DucMinhLe2005/Human-Aware---Social-Navigation/docs/images/human_aware_navigation_pipeline.png

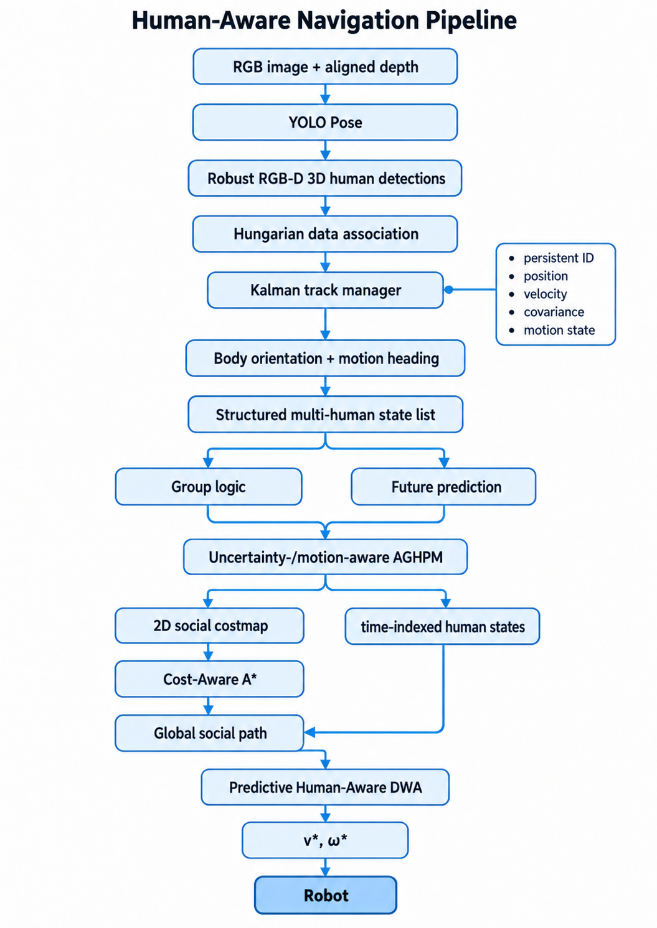
docs/images/human_aware_navigation_pipeline.png
