DucMinhLe2005/Human-Aware---Social-Navigation/docs/images/robot_cad.webp

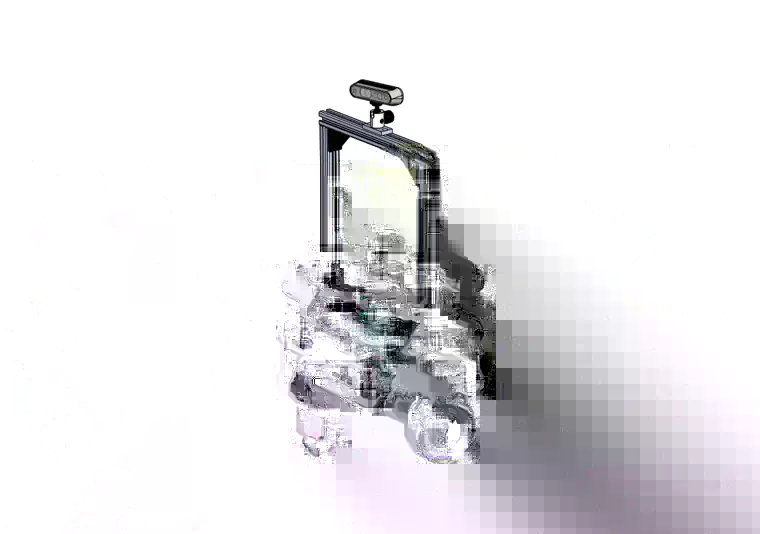
docs/images/robot_cad.webp
