DucMinhLe2005/Human-Aware---Social-Navigation/src_humanaware/src/linorobot2/linorobot2_description/meshes/my_amr/wheel_right.STL

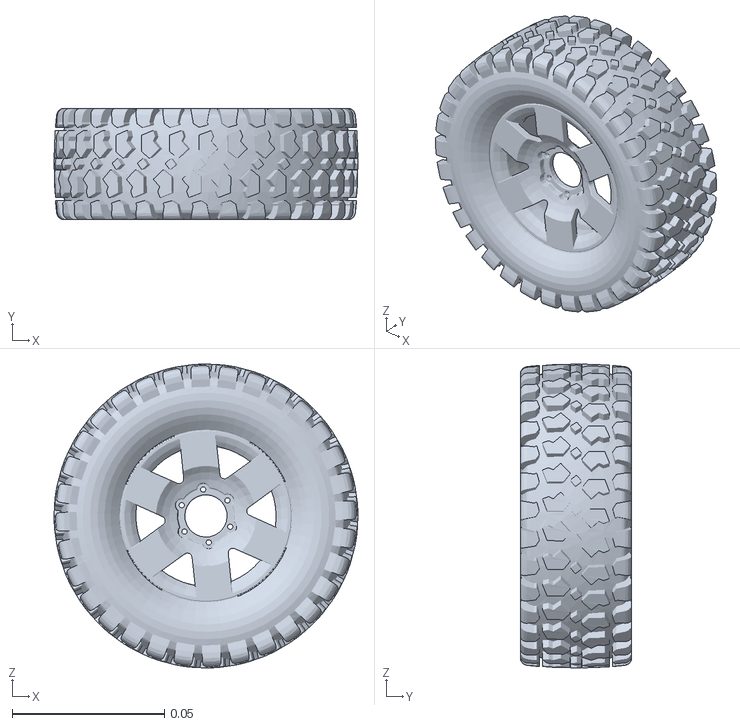
[picture p29: CAD file, 2026-10-07]
src_humanaware/src/linorobot2/linorobot2_description/meshes/my_amr/wheel_right.STL
0.1 x 0.0366 x 0.1
