DucMinhLe2005/Human-Aware---Social-Navigation/src_humanaware/src/linorobot2/linorobot2_gazebo/models/nurse/meshes/Nurse.obj

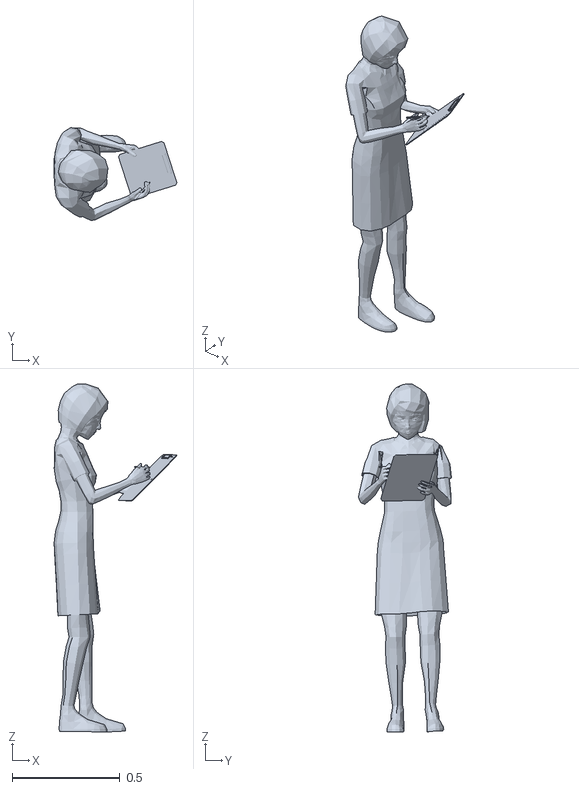
[picture p30: CAD file, 2026-10-07]
src_humanaware/src/linorobot2/linorobot2_gazebo/models/nurse/meshes/Nurse.obj
0.57 x 0.432 x 1.62
