DucMinhLe2005/Human-Aware---Social-Navigation/src_humanaware/src/linorobot2/linorobot2_gazebo/models/nurse/meshes/Nurse_Col.obj

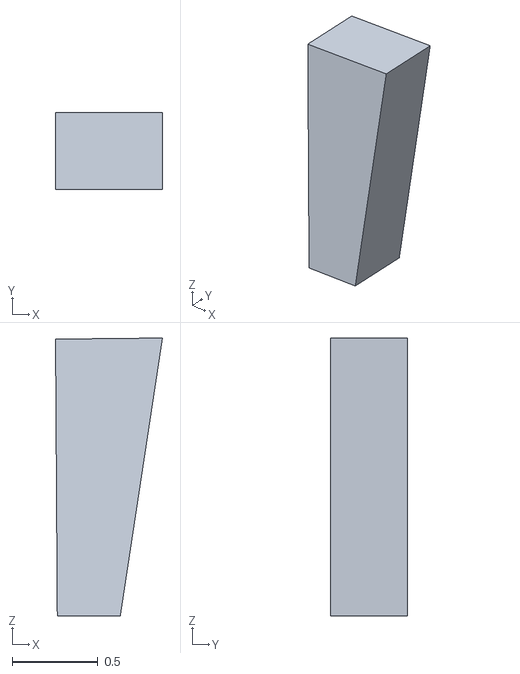
[picture p31: CAD file, 2026-10-07]
src_humanaware/src/linorobot2/linorobot2_gazebo/models/nurse/meshes/Nurse_Col.obj
0.622 x 0.446 x 1.62
