DucMinhLe2005/Human-Aware---Social-Navigation/src_humanaware/src/linorobot2/linorobot2_description/meshes/my_amr/caster_front.STL

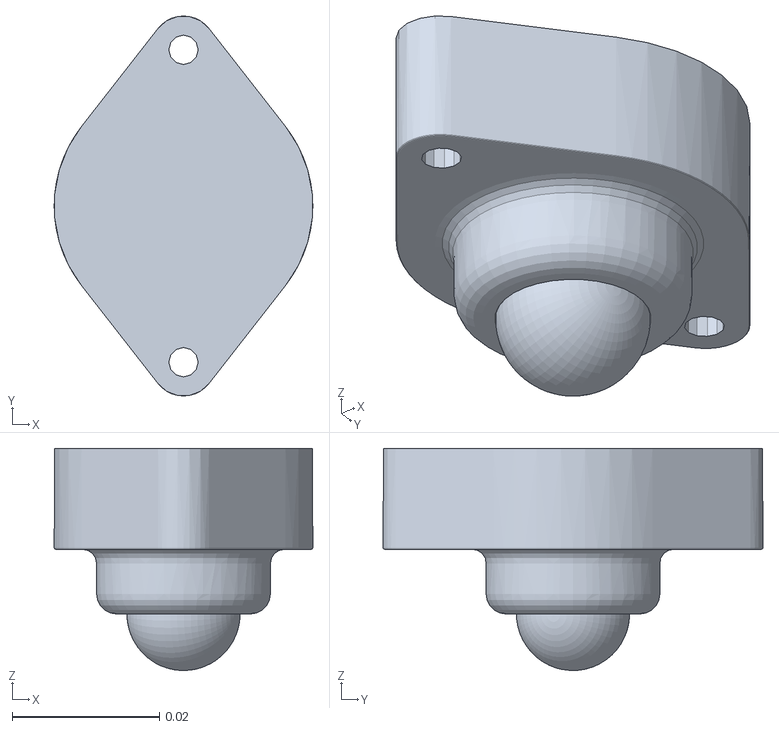
[picture p32: CAD file, 2026-10-07]
src_humanaware/src/linorobot2/linorobot2_description/meshes/my_amr/caster_front.STL
0.0352 x 0.0517 x 0.0302
