DucMinhLe2005/Human-Aware---Social-Navigation/src_humanaware/src/linorobot2/linorobot2_description/meshes/my_amr/imu_link.STL

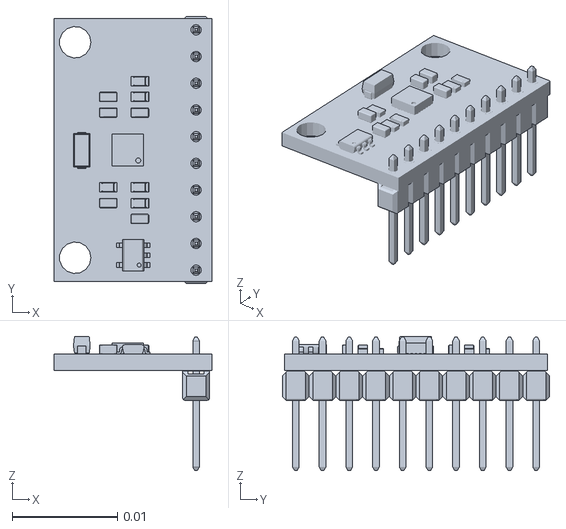
[picture p33: CAD file, 2026-10-07]
src_humanaware/src/linorobot2/linorobot2_description/meshes/my_amr/imu_link.STL
0.015 x 0.0254 x 0.0128
