DucMinhLe2005/Human-Aware---Social-Navigation/src_humanaware/src/linorobot2/linorobot2_description/meshes/my_amr/lidar_link.STL

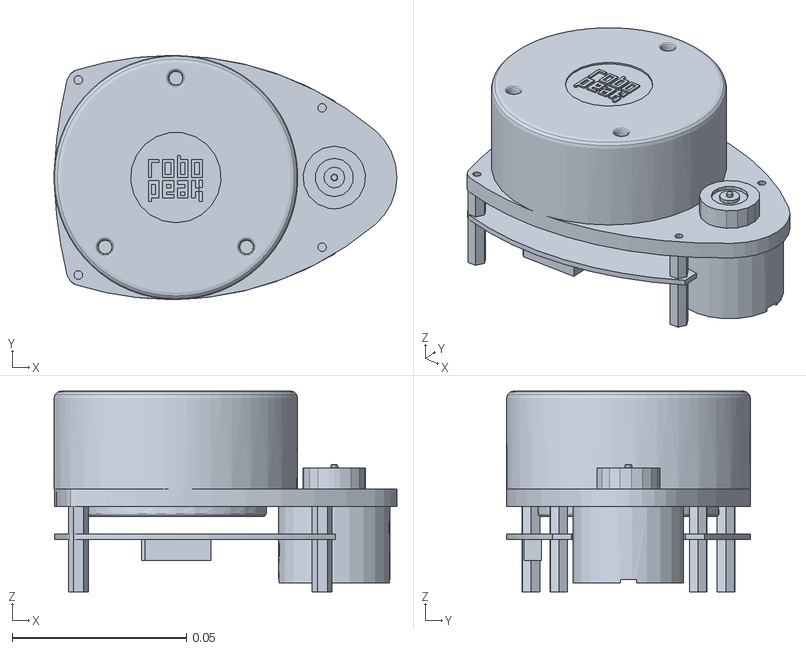
[picture p34: CAD file, 2026-10-07]
src_humanaware/src/linorobot2/linorobot2_description/meshes/my_amr/lidar_link.STL
0.0985 x 0.07 x 0.0577
