DucMinhLe2005/Human-Aware---Social-Navigation/src_humanaware/src/linorobot2/linorobot2_description/meshes/my_amr/camera_link.STL

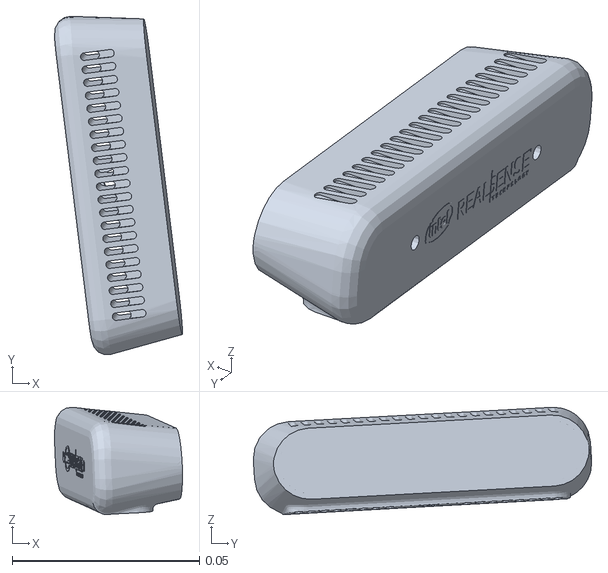
[picture p35: CAD file, 2026-10-07]
src_humanaware/src/linorobot2/linorobot2_description/meshes/my_amr/camera_link.STL
0.0342 x 0.0903 x 0.0287
