DucMinhLe2005/Human-Aware---Social-Navigation/(list of files, cad)

Other CAD files:
src_humanaware/src/linorobot2/linorobot2_description/meshes/my_amr/wheel_left.STL
src_humanaware/src/linorobot2/linorobot2_description/meshes/my_amr/caster_rear.STL
