DucMinhLe2005/Human-Aware---Social-Navigation/linorobot2_hardware/firmware/src/firmware.ino

// Copyright (c) 2021 Juan Miguel Jimeno
//
// Licensed under the Apache License, Version 2.0 (the "License");
// you may not use this file except in compliance with the License.
// You may obtain a copy of the License at
//
//     http://www.apache.org/licenses/LICENSE-2.0
//
// Unless required by applicable law or agreed to in writing, software
// distributed under the License is distributed on an "AS IS" BASIS,
// WITHOUT WARRANTIES OR CONDITIONS OF ANY KIND, either express or implied.
// See the License for the specific language governing permissions and
// limitations under the License.
#include <Arduino.h>
#include <micro_ros_platformio.h>
#include <stdio.h>

#include <rcl/rcl.h>
#include <rcl/error_handling.h>
#include <rclc/rclc.h>
#include <rclc/executor.h>

#include <nav_msgs/msg/odometry.h>
#include <sensor_msgs/msg/imu.h>
#include <sensor_msgs/msg/magnetic_field.h>
#include <geometry_msgs/msg/twist.h>
#include <geometry_msgs/msg/vector3.h>

#include "config.h"
#include "syslog.h"
#include "motor.h"
#include "kinematics.h"
#include "pid.h"
#include "odometry.h"
#include "imu.h"
#include "mag.h"
#define ENCODER_USE_INTERRUPTS
#define ENCODER_OPTIMIZE_INTERRUPTS
#include "encoder.h"
#include "lidar.h"
#include "wifis.h"
#include "ota.h"

#ifdef MICRO_ROS_TRANSPORT_ARDUINO_WIFI
// remove wifi initialization code from wifi transport
static inline void set_microros_net_transports(IPAddress agent_ip, uint16_t agent_port)
{
    static struct micro_ros_agent_locator locator;
    locator.address = agent_ip;
    locator.port = agent_port;

    rmw_uros_set_custom_transport(
        false,
        (void *) &locator,
        platformio_transport_open,
        platformio_transport_close,
        platformio_transport_write,
        platformio_transport_read
    );
}
#endif

#ifndef NODE_NAME
#define NODE_NAME "linorobot_base_node"
#endif

#ifndef RCCHECK
#define RCCHECK(fn) { rcl_ret_t temp_rc = fn; if((temp_rc != RCL_RET_OK)){rclErrorLoop();}}
#endif
#define RCSOFTCHECK(fn) { rcl_ret_t temp_rc = fn; if((temp_rc != RCL_RET_OK)){}}
#define EXECUTE_EVERY_N_MS(MS, X)  do { \
  static volatile int64_t init = -1; \
  if (init == -1) { init = uxr_millis();} \
  if (uxr_millis() - init > MS) { X; init = uxr_millis();} \
} while (0)

rcl_publisher_t odom_publisher;
rcl_publisher_t imu_publisher;
rcl_publisher_t mag_publisher;
rcl_publisher_t pid_setpoint_publisher;
rcl_publisher_t pid_measured_publisher;
rcl_publisher_t pid_output_publisher;

rcl_subscription_t twist_subscriber;
rcl_subscription_t pid_gains_subscriber;

nav_msgs__msg__Odometry odom_msg;
sensor_msgs__msg__Imu imu_msg;
sensor_msgs__msg__MagneticField mag_msg;
geometry_msgs__msg__Twist twist_msg;
geometry_msgs__msg__Vector3 pid_gains_msg;
geometry_msgs__msg__Vector3 pid_setpoint_msg;
geometry_msgs__msg__Vector3 pid_measured_msg;
geometry_msgs__msg__Vector3 pid_output_msg;

rclc_executor_t executor;
rclc_support_t support;
rcl_allocator_t allocator;
rcl_node_t node;
rcl_timer_t control_timer;

unsigned long long time_offset = 0;
unsigned long prev_cmd_time = 0;
unsigned long prev_odom_update = 0;

enum states
{
    WAITING_AGENT,
    AGENT_AVAILABLE,
    AGENT_CONNECTED,
    AGENT_DISCONNECTED
};

states state = WAITING_AGENT;

bool cmd_vel_received = false;

Encoder motor1_encoder(MOTOR1_ENCODER_A, MOTOR1_ENCODER_B, COUNTS_PER_REV1, MOTOR1_ENCODER_INV);
Encoder motor2_encoder(MOTOR2_ENCODER_A, MOTOR2_ENCODER_B, COUNTS_PER_REV2, MOTOR2_ENCODER_INV);
Encoder motor3_encoder(MOTOR3_ENCODER_A, MOTOR3_ENCODER_B, COUNTS_PER_REV3, MOTOR3_ENCODER_INV);
Encoder motor4_encoder(MOTOR4_ENCODER_A, MOTOR4_ENCODER_B, COUNTS_PER_REV4, MOTOR4_ENCODER_INV);

Motor motor1_controller(PWM_FREQUENCY, PWM_BITS, MOTOR1_INV, MOTOR1_PWM, MOTOR1_IN_A, MOTOR1_IN_B);
Motor motor2_controller(PWM_FREQUENCY, PWM_BITS, MOTOR2_INV, MOTOR2_PWM, MOTOR2_IN_A, MOTOR2_IN_B);
Motor motor3_controller(PWM_FREQUENCY, PWM_BITS, MOTOR3_INV, MOTOR3_PWM, MOTOR3_IN_A, MOTOR3_IN_B);
Motor motor4_controller(PWM_FREQUENCY, PWM_BITS, MOTOR4_INV, MOTOR4_PWM, MOTOR4_IN_A, MOTOR4_IN_B);

PID motor1_pid(PWM_MIN, PWM_MAX, K_P, K_I, K_D);
PID motor2_pid(PWM_MIN, PWM_MAX, K_P, K_I, K_D);
PID motor3_pid(PWM_MIN, PWM_MAX, K_P, K_I, K_D);
PID motor4_pid(PWM_MIN, PWM_MAX, K_P, K_I, K_D);

Kinematics kinematics(
    Kinematics::LINO_BASE, 
    MOTOR_MAX_RPM, 
    MAX_RPM_RATIO, 
    MOTOR_OPERATING_VOLTAGE, 
    MOTOR_POWER_MAX_VOLTAGE, 
    WHEEL_DIAMETER, 
    LR_WHEELS_DISTANCE
);

Odometry odometry;
IMU imu;
MAG mag;

#ifndef BAUDRATE
#define BAUDRATE 921600
#endif

void setup() 
{
    pinMode(LED_PIN, OUTPUT);
    Serial.begin(BAUDRATE);
#ifdef ESP32
    Serial.setRxBufferSize(1024);
#endif

#ifdef BOARD_INIT // board specific setup, must include Wire.begin
    BOARD_INIT
#else
    Wire.begin();
#endif

    initWifis();
    initOta();
    bool imu_ok = imu.init();
    if (!imu_ok) // take IMU failure as fatal
    {
        Serial.println("IMU init failed");
        syslog(LOG_INFO, "%s IMU init failed %lu", __FUNCTION__, millis());
        while (1)
        {
            flashLED(3); // flash 3 times
            runWifis();
            runOta();
        }
    }
    bool mag_ok = mag.init();
    if (!mag_ok) // take mag failure as fatal
    {
        Serial.println("MAG init failed");
        syslog(LOG_INFO, "%s MAG init failed %lu", __FUNCTION__, millis());
        while (1)
        {
            flashLED(4); // flash 4 times
            runWifis();
            runOta();
        }
    }
    initLidar(); // after wifi connected

#ifdef MICRO_ROS_TRANSPORT_ARDUINO_WIFI
    set_microros_net_transports(AGENT_IP, AGENT_PORT);
#else
    set_microros_serial_transports(Serial);
#endif

#ifdef BOARD_INIT_LATE // board specific setup
    BOARD_INIT_LATE
#endif
    syslog(LOG_INFO, "%s Ready %lu", __FUNCTION__, millis());
}

void loop() {
    switch (state) 
    {
        case WAITING_AGENT:
            EXECUTE_EVERY_N_MS(500, state = (RMW_RET_OK == rmw_uros_ping_agent(100, 1)) ? AGENT_AVAILABLE : WAITING_AGENT;);
            break;
        case AGENT_AVAILABLE:
            syslog(LOG_INFO, "%s agent available %lu", __FUNCTION__, millis());
            state = (true == createEntities()) ? AGENT_CONNECTED : WAITING_AGENT;
            if (state == WAITING_AGENT) 
            {
                destroyEntities();
            }
            break;
        case AGENT_CONNECTED:
#ifndef USE_STAY_CONNECTED // Stay connected. Do not ping.
            EXECUTE_EVERY_N_MS(200, state = (RMW_RET_OK == rmw_uros_ping_agent(100, 1)) ? AGENT_CONNECTED : AGENT_DISCONNECTED;);
#endif
            if (state == AGENT_CONNECTED) 
            {
                rclc_executor_spin_some(&executor, RCL_MS_TO_NS(10));
            }
            break;
        case AGENT_DISCONNECTED:
            syslog(LOG_INFO, "%s agent disconnected %lu", __FUNCTION__, millis());
            fullStop();
            destroyEntities();
            state = WAITING_AGENT;
            break;
        default:
            break;
    }
    runWifis();
    runOta();
#ifdef WDT_TIMEOUT
    esp_task_wdt_reset();
#endif
#ifdef BOARD_LOOP // board specific loop
    BOARD_LOOP
#endif
}

void controlCallback(rcl_timer_t * timer, int64_t last_call_time) 
{
    RCLC_UNUSED(last_call_time);
    if (timer != NULL) 
    {
       moveBase();
       publishData();
    }
}

void twistCallback(const void *msgin)
{
    if (msgin == NULL)
    {
        return;
    }

    const geometry_msgs__msg__Twist *received_msg =
        static_cast<const geometry_msgs__msg__Twist *>(msgin);

    // Chép lệnh cmd_vel mới vào biến điều khiển
    twist_msg.linear.x  = received_msg->linear.x;
    twist_msg.linear.y  = received_msg->linear.y;
    twist_msg.linear.z  = received_msg->linear.z;

    twist_msg.angular.x = received_msg->angular.x;
    twist_msg.angular.y = received_msg->angular.y;
    twist_msg.angular.z = received_msg->angular.z;

    prev_cmd_time = millis();
    cmd_vel_received = true;

    digitalWrite(LED_PIN, !digitalRead(LED_PIN));
}

void pidGainsCallback(const void *msgin)
{
    if (msgin == NULL)
    {
        return;
    }

    const geometry_msgs__msg__Vector3 *gains =
        static_cast<const geometry_msgs__msg__Vector3 *>(msgin);

    const float kp = static_cast<float>(gains->x);
    const float ki = static_cast<float>(gains->y);
    const float kd = static_cast<float>(gains->z);

    // Chỉ nhận hệ số hữu hạn và không âm.
    if (!isfinite(kp) || !isfinite(ki) || !isfinite(kd) ||
        kp < 0.0f || ki < 0.0f || kd < 0.0f)
    {
        return;
    }

    motor1_pid.updateConstants(kp, ki, kd);
    motor2_pid.updateConstants(kp, ki, kd);
    motor3_pid.updateConstants(kp, ki, kd);
    motor4_pid.updateConstants(kp, ki, kd);

    // Xóa trạng thái tích phân/vi phân cũ trước khi thử bộ gain mới.
    motor1_pid.reset();
    motor2_pid.reset();
    motor3_pid.reset();
    motor4_pid.reset();

    fullStop();
}

bool createEntities()
{
    syslog(LOG_INFO, "%s %lu", __FUNCTION__, millis());
    allocator = rcl_get_default_allocator();
    //create init_options
    RCCHECK(rclc_support_init(&support, 0, NULL, &allocator));
    // create node
    RCCHECK(rclc_node_init_default(&node, NODE_NAME, "", &support));
    // create odometry publisher
    RCCHECK(rclc_publisher_init_default( 
        &odom_publisher, 
        &node,
        ROSIDL_GET_MSG_TYPE_SUPPORT(nav_msgs, msg, Odometry),
        "odom/unfiltered"
    ));
    // create IMU publisher
    RCCHECK(rclc_publisher_init_default( 
        &imu_publisher, 
        &node,
        ROSIDL_GET_MSG_TYPE_SUPPORT(sensor_msgs, msg, Imu),
    // if we have magnetomter, use imu/data_raw for madgwick filter
#ifndef USE_FAKE_MAG
        "imu/data_raw"
#else
        "imu/data"
#endif
    ));
#ifndef USE_FAKE_MAG
    RCCHECK(rclc_publisher_init_default(
        &mag_publisher,
        &node,
        ROSIDL_GET_MSG_TYPE_SUPPORT(sensor_msgs, msg, MagneticField),
        "imu/mag"
    ));
#endif
    // create twist command subscriber
    RCCHECK(rclc_subscription_init_default( 
        &twist_subscriber, 
        &node,
        ROSIDL_GET_MSG_TYPE_SUPPORT(geometry_msgs, msg, Twist),
        "cmd_vel"
    ));

    // PID gains: x=Kp, y=Ki, z=Kd
    RCCHECK(rclc_subscription_init_default(
        &pid_gains_subscriber,
        &node,
        ROSIDL_GET_MSG_TYPE_SUPPORT(geometry_msgs, msg, Vector3),
        "pid/gains"
    ));

    // PID debug topics: x=motor1, y=motor2
    RCCHECK(rclc_publisher_init_default(
        &pid_setpoint_publisher,
        &node,
        ROSIDL_GET_MSG_TYPE_SUPPORT(geometry_msgs, msg, Vector3),
        "pid/setpoint"
    ));
    RCCHECK(rclc_publisher_init_default(
        &pid_measured_publisher,
        &node,
        ROSIDL_GET_MSG_TYPE_SUPPORT(geometry_msgs, msg, Vector3),
        "pid/measured"
    ));
    RCCHECK(rclc_publisher_init_default(
        &pid_output_publisher,
        &node,
        ROSIDL_GET_MSG_TYPE_SUPPORT(geometry_msgs, msg, Vector3),
        "pid/output"
    ));
    // create timer for actuating the motors at 50 Hz (1000/20)
    const unsigned int control_timeout = 20;
    RCCHECK(rclc_timer_init_default2( 
        &control_timer, 
        &support,
        RCL_MS_TO_NS(control_timeout),
        controlCallback,
        true
    ));
    executor = rclc_executor_get_zero_initialized_executor();
    RCCHECK(rclc_executor_init(&executor, &support.context, 3, &allocator));
    RCCHECK(rclc_executor_add_subscription(
        &executor, 
        &twist_subscriber, 
        &twist_msg, 
        &twistCallback, 
        ON_NEW_DATA
    ));
    RCCHECK(rclc_executor_add_subscription(
        &executor,
        &pid_gains_subscriber,
        &pid_gains_msg,
        &pidGainsCallback,
        ON_NEW_DATA
    ));
    RCCHECK(rclc_executor_add_timer(&executor, &control_timer));

    // synchronize time with the agent
    syncTime();
    digitalWrite(LED_PIN, HIGH);

    return true;
}

bool destroyEntities()
{
    rmw_context_t * rmw_context = rcl_context_get_rmw_context(&support.context);
    (void) rmw_uros_set_context_entity_destroy_session_timeout(rmw_context, 0);

    RCSOFTCHECK(rcl_publisher_fini(&odom_publisher, &node));
    RCSOFTCHECK(rcl_publisher_fini(&imu_publisher, &node));
#ifndef USE_FAKE_MAG
    RCSOFTCHECK(rcl_publisher_fini(&mag_publisher, &node));
#endif
    RCSOFTCHECK(rcl_publisher_fini(&pid_setpoint_publisher, &node));
    RCSOFTCHECK(rcl_publisher_fini(&pid_measured_publisher, &node));
    RCSOFTCHECK(rcl_publisher_fini(&pid_output_publisher, &node));
    RCSOFTCHECK(rcl_subscription_fini(&twist_subscriber, &node));
    RCSOFTCHECK(rcl_subscription_fini(&pid_gains_subscriber, &node));
    RCSOFTCHECK(rcl_timer_fini(&control_timer));
    RCSOFTCHECK(rclc_executor_fini(&executor));
    RCSOFTCHECK(rcl_node_fini(&node))
    RCSOFTCHECK(rclc_support_fini(&support));

    digitalWrite(LED_PIN, HIGH);
    
    return true;
}

void fullStop()
{
    twist_msg.linear.x = 0.0;
    twist_msg.linear.y = 0.0;
    twist_msg.linear.z = 0.0;

    twist_msg.angular.x = 0.0;
    twist_msg.angular.y = 0.0;
    twist_msg.angular.z = 0.0;

    // Đặt PWM bằng 0 trước
    motor1_controller.spin(0);
    motor2_controller.spin(0);
    motor3_controller.spin(0);
    motor4_controller.spin(0);

    // Sau đó phanh driver
    motor1_controller.brake();
    motor2_controller.brake();
    motor3_controller.brake();
    motor4_controller.brake();

    // Xóa trạng thái PID để không giữ tích phân khi dừng.
    motor1_pid.reset();
    motor2_pid.reset();
    motor3_pid.reset();
    motor4_pid.reset();

    pid_setpoint_msg.x = 0.0;
    pid_setpoint_msg.y = 0.0;
    pid_setpoint_msg.z = 0.0;
    pid_output_msg.x = 0.0;
    pid_output_msg.y = 0.0;
    pid_output_msg.z = 0.0;

    digitalWrite(LED_PIN, HIGH);
}

void moveBase()
{
    const unsigned long now = millis();

    const bool command_timeout =
        !cmd_vel_received ||
        ((now - prev_cmd_time) >= 200);

    const double command_epsilon = 0.0001;

    const bool zero_command =
        fabs(twist_msg.linear.x) < command_epsilon &&
        fabs(twist_msg.linear.y) < command_epsilon &&
        fabs(twist_msg.angular.z) < command_epsilon;

    /*
     * Phanh ngay khi:
     * - Chưa từng nhận cmd_vel
     * - Mất cmd_vel quá 200 ms
     * - Teleop gửi lệnh dừng k
     */
    if (command_timeout || zero_command)
    {
        fullStop();

        // Vẫn đọc encoder để odometry có thể cập nhật lúc bánh giảm tốc
        const float current_rpm1 = motor1_encoder.getRPM();
        const float current_rpm2 = motor2_encoder.getRPM();
        const float current_rpm3 = motor3_encoder.getRPM();
        const float current_rpm4 = motor4_encoder.getRPM();

        pid_measured_msg.x = current_rpm1;
        pid_measured_msg.y = current_rpm2;
        pid_measured_msg.z = 0.0;

        Kinematics::velocities current_vel =
            kinematics.getVelocities(
                current_rpm1,
                current_rpm2,
                current_rpm3,
                current_rpm4
            );

        const unsigned long odom_now = millis();
        const float vel_dt =
            (odom_now - prev_odom_update) / 1000.0f;

        prev_odom_update = odom_now;

        odometry.update(
            vel_dt,
            current_vel.linear_x,
            current_vel.linear_y,
            current_vel.angular_z
        );

        return;
    }

    // Chuyển cmd_vel thành RPM yêu cầu
    Kinematics::rpm req_rpm =
        kinematics.getRPM(
            twist_msg.linear.x,
            twist_msg.linear.y,
            twist_msg.angular.z
        );

    // RPM thực tế từ encoder
    const float current_rpm1 = motor1_encoder.getRPM();
    const float current_rpm2 = motor2_encoder.getRPM();
    const float current_rpm3 = motor3_encoder.getRPM();
    const float current_rpm4 = motor4_encoder.getRPM();

    // Điều khiển PID
    const double pwm1 = motor1_pid.compute(req_rpm.motor1, current_rpm1);
    const double pwm2 = motor2_pid.compute(req_rpm.motor2, current_rpm2);
    const double pwm3 = motor3_pid.compute(req_rpm.motor3, current_rpm3);
    const double pwm4 = motor4_pid.compute(req_rpm.motor4, current_rpm4);

    motor1_controller.spin(pwm1);
    motor2_controller.spin(pwm2);
    motor3_controller.spin(pwm3);
    motor4_controller.spin(pwm4);

    pid_setpoint_msg.x = req_rpm.motor1;
    pid_setpoint_msg.y = req_rpm.motor2;
    pid_setpoint_msg.z = 0.0;

    pid_measured_msg.x = current_rpm1;
    pid_measured_msg.y = current_rpm2;
    pid_measured_msg.z = 0.0;

    pid_output_msg.x = pwm1;
    pid_output_msg.y = pwm2;
    pid_output_msg.z = 0.0;

    // Tính vận tốc robot
    Kinematics::velocities current_vel =
        kinematics.getVelocities(
            current_rpm1,
            current_rpm2,
            current_rpm3,
            current_rpm4
        );

    const unsigned long odom_now = millis();
    const float vel_dt =
        (odom_now - prev_odom_update) / 1000.0f;

    prev_odom_update = odom_now;

    odometry.update(
        vel_dt,
        current_vel.linear_x,
        current_vel.linear_y,
        current_vel.angular_z
    );
}

void publishData()
{
    odom_msg = odometry.getData();
    imu_msg = imu.getData();
#ifdef USE_FAKE_IMU
    imu_msg.angular_velocity.z = odom_msg.twist.twist.angular.z;
#endif
    mag_msg = mag.getData();
#ifdef MAG_BIAS
    const float mag_bias[3] = MAG_BIAS;
    mag_msg.magnetic_field.x -= mag_bias[0];
    mag_msg.magnetic_field.y -= mag_bias[1];
    mag_msg.magnetic_field.z -= mag_bias[2];
#endif

    struct timespec time_stamp = getTime();

    odom_msg.header.stamp.sec = time_stamp.tv_sec;
    odom_msg.header.stamp.nanosec = time_stamp.tv_nsec;

    imu_msg.header.stamp.sec = time_stamp.tv_sec;
    imu_msg.header.stamp.nanosec = time_stamp.tv_nsec;

    mag_msg.header.stamp.sec = time_stamp.tv_sec;
    mag_msg.header.stamp.nanosec = time_stamp.tv_nsec;

    RCSOFTCHECK(rcl_publish(&imu_publisher, &imu_msg, NULL));
#ifndef USE_FAKE_MAG
    RCSOFTCHECK(rcl_publish(&mag_publisher, &mag_msg, NULL));
#endif
    RCSOFTCHECK(rcl_publish(&odom_publisher, &odom_msg, NULL));
    RCSOFTCHECK(rcl_publish(&pid_setpoint_publisher, &pid_setpoint_msg, NULL));
    RCSOFTCHECK(rcl_publish(&pid_measured_publisher, &pid_measured_msg, NULL));
    RCSOFTCHECK(rcl_publish(&pid_output_publisher, &pid_output_msg, NULL));
}

bool syncTime()
{
    const int timeout_ms = 1000;
    if (rmw_uros_epoch_synchronized()) return true; // synchronized previously
    // get the current time from the agent
    RCCHECK(rmw_uros_sync_session(timeout_ms));
    if (rmw_uros_epoch_synchronized()) {
#if (_POSIX_TIMERS > 0)
        // Get time in milliseconds or nanoseconds
        int64_t time_ns = rmw_uros_epoch_nanos();
    timespec tp;
    tp.tv_sec = time_ns / 1000000000;
    tp.tv_nsec = time_ns % 1000000000;
    clock_settime(CLOCK_REALTIME, &tp);
#else
    unsigned long long ros_time_ms = rmw_uros_epoch_millis();
    // now we can find the difference between ROS time and uC time
    time_offset = ros_time_ms - millis();
#endif
    return true;
    }
    return false;
}

struct timespec getTime()
{
    struct timespec tp = {0};
#if (_POSIX_TIMERS > 0)
    clock_gettime(CLOCK_REALTIME, &tp);
#else
    // add time difference between uC time and ROS time to
    // synchronize time with ROS
    unsigned long long now = millis() + time_offset;
    tp.tv_sec = now / 1000;
    tp.tv_nsec = (now % 1000) * 1000000;
#endif
    return tp;
}

void rclErrorLoop() 
{
    while(true)
    {
        flashLED(2);
    }
}

void flashLED(int n_times)
{
    for(int i=0; i<n_times; i++)
    {
        digitalWrite(LED_PIN, HIGH);
        delay(150);
        digitalWrite(LED_PIN, LOW);
        delay(150);
    }
    delay(1000);
}
