DucMinhLe2005/Human-Aware---Social-Navigation/linorobot2_hardware/config/custom/esp32_config.h

// Copyright (c) 2021 Juan Miguel Jimeno
//
// Licensed under the Apache License, Version 2.0 (the "License");
// you may not use this file except in compliance with the License.
// You may obtain a copy of the License at
//
//     http://www.apache.org/licenses/LICENSE-2.0
//
// Unless required by applicable law or agreed to in writing, software
// distributed under the License is distributed on an "AS IS" BASIS,
// WITHOUT WARRANTIES OR CONDITIONS OF ANY KIND, either express or implied.
// See the License for the specific language governing permissions and
// limitations under the License.

#ifndef ESP32_CONFIG_H
#define ESP32_CONFIG_H

#define LED_PIN LED_BUILTIN //used for debugging status

//uncomment the base you're building
#define LINO_BASE DIFFERENTIAL_DRIVE       // 2WD and Tracked robot w/ 2 motors
// #define LINO_BASE SKID_STEER            // 4WD robot
// #define LINO_BASE MECANUM               // Mecanum drive robot

//uncomment the motor driver you're using
// #define USE_GENERIC_2_IN_MOTOR_DRIVER      // Motor drivers with 2 Direction Pins(INA, INB) and 1 PWM(ENABLE) pin ie. L298, L293, VNH5019
// #define USE_GENERIC_1_IN_MOTOR_DRIVER   // Motor drivers with 1 Direction Pin(INA) and 1 PWM(ENABLE) pin.
#define USE_BTS7960_MOTOR_DRIVER        // BTS7970 Motor Driver using A4950 (<40V) module or DRV8833 (<10V)
// #define USE_ESC_MOTOR_DRIVER            // Motor ESC for brushless motors

//uncomment the IMU you're using
// #define USE_GY85_IMU
// #define USE_MPU6050_IMU
// #define USE_MPU9150_IMU
#define USE_MPU9250_IMU
// #define USE_QMI8658_IMU
// #define USE_HMC5883L_MAG
// #define USE_AK8963_MAG

// #define USE_AK8975_MAG
// #define USE_AK09918_MAG
// #define USE_QMC5883L_MAG
// #define MAG_BIAS { 0, 0, 0 }
// accelerometer scale correction: measured at-rest magnitude was 10.68 m/s^2
// instead of 9.81 m/s^2, so scale all axes by 9.81/10.68 to correct
#define IMU_TWEAK { \
    imu_msg_.linear_acceleration.x *= 0.918230; \
    imu_msg_.linear_acceleration.y *= 0.918230; \
    imu_msg_.linear_acceleration.z *= 0.918230; \
}
// #define MAG_TWEAK {}

#define ACCEL_COV { 0.01, 0.01, 0.01 }
#define GYRO_COV { 0.001, 0.001, 0.001 }
#define ORI_COV { 0.01, 0.01, 0.01 }
#define MAG_COV { 1e-12, 1e-12, 1e-12 }
#define POSE_COV { 0.001, 0.001, 0.001, 0.001, 0.001, 0.001 }
#define TWIST_COV { 0.001, 0.001, 0.001, 0.003, 0.003, 0.003 }

#define K_P 0.6                             // P constant
#define K_I 0.8                             // I constant
#define K_D 0.5                             // D constant

/*
ROBOT ORIENTATION
         FRONT
    MOTOR1  MOTOR2  (2WD/ACKERMANN)
    MOTOR3  MOTOR4  (4WD/MECANUM)
         BACK
*/

//define your robot' specs here
#define MOTOR_MAX_RPM 110                   // motor's max RPM
#define MAX_RPM_RATIO 0.6                  // max RPM allowed for each MAX_RPM_ALLOWED = MOTOR_MAX_RPM * MAX_RPM_RATIO
#define MOTOR_OPERATING_VOLTAGE 12          // motor's operating voltage (used to calculate max RPM)
#define MOTOR_POWER_MAX_VOLTAGE 12          // max voltage of the motor's power source (used to calculate max RPM)
#define MOTOR_POWER_MEASURED_VOLTAGE 11.7     // current voltage reading of the power connected to the motor (used for calibration)
#define COUNTS_PER_REV1 1700                // wheel1 encoder's no of ticks per rev
#define COUNTS_PER_REV2 1700                 // wheel2 encoder's no of ticks per rev
#define COUNTS_PER_REV3 1                 // wheel3 encoder's no of ticks per rev
#define COUNTS_PER_REV4 1                 // wheel4 encoder's no of ticks per rev
#define WHEEL_DIAMETER 0.08               // wheel's diameter in meters
#define LR_WHEELS_DISTANCE 0.3           // distance between left and right wheels (measured)
#define PWM_BITS 10                         // PWM Resolution of the microcontroller
#define PWM_FREQUENCY 20000                 // PWM Frequency

// INVERT ENCODER COUNTS
#define MOTOR1_ENCODER_INV false
#define MOTOR2_ENCODER_INV false
#define MOTOR3_ENCODER_INV false
#define MOTOR4_ENCODER_INV false

// INVERT MOTOR DIRECTIONS
#define MOTOR1_INV false
#define MOTOR2_INV false
#define MOTOR3_INV false
#define MOTOR4_INV false

// ENCODER PINS
#define MOTOR1_ENCODER_A 18
#define MOTOR1_ENCODER_B 19 

#define MOTOR2_ENCODER_A 16
#define MOTOR2_ENCODER_B 17

#define MOTOR3_ENCODER_A -1
#define MOTOR3_ENCODER_B -1

#define MOTOR4_ENCODER_A -1
#define MOTOR4_ENCODER_B -1


// MOTOR PINS
#ifdef USE_GENERIC_2_IN_MOTOR_DRIVER
  #define MOTOR1_PWM 21
  #define MOTOR1_IN_A 20
  #define MOTOR1_IN_B 1

  #define MOTOR2_PWM 5
  #define MOTOR2_IN_A 6
  #define MOTOR2_IN_B 8

  #define MOTOR3_PWM 22
  #define MOTOR3_IN_A 23
  #define MOTOR3_IN_B 0

  #define MOTOR4_PWM 4
  #define MOTOR4_IN_A 3
  #define MOTOR4_IN_B 2

  #define PWM_MAX pow(2, PWM_BITS) - 1
  #define PWM_MIN -PWM_MAX
#endif

#ifdef USE_GENERIC_1_IN_MOTOR_DRIVER
  #define MOTOR1_PWM 21
  #define MOTOR1_IN_A 20
  #define MOTOR1_IN_B -1 //DON'T TOUCH THIS! This is just a placeholder

  #define MOTOR2_PWM 5
  #define MOTOR2_IN_A 6
  #define MOTOR2_IN_B -1 //DON'T TOUCH THIS! This is just a placeholder

  #define MOTOR3_PWM 22
  #define MOTOR3_IN_A 23
  #define MOTOR3_IN_B -1 //DON'T TOUCH THIS! This is just a placeholder

  #define MOTOR4_PWM 4
  #define MOTOR4_IN_A 3
  #define MOTOR4_IN_B -1 //DON'T TOUCH THIS! This is just a placeholder

  #define PWM_MAX pow(2, PWM_BITS) - 1
  #define PWM_MIN -PWM_MAX
#endif

#ifdef USE_BTS7960_MOTOR_DRIVER

  // MOTOR 1
  // IN_A = RPWM
  // IN_B = LPWM
  #define MOTOR1_PWM  -1
  #define MOTOR1_IN_A 33
  #define MOTOR1_IN_B 26

  // MOTOR 2
  #define MOTOR2_PWM  -1
  #define MOTOR2_IN_A 27
  #define MOTOR2_IN_B 14

  // Không dùng motor 3 và 4
  #define MOTOR3_PWM  -1
  #define MOTOR3_IN_A -1
  #define MOTOR3_IN_B -1

  #define MOTOR4_PWM  -1
  #define MOTOR4_IN_A -1
  #define MOTOR4_IN_B -1

  #define PWM_MAX pow(2, PWM_BITS) - 1
  #define PWM_MIN -PWM_MAX

#endif

#ifdef USE_ESC_MOTOR_DRIVER
  #define MOTOR1_PWM 21
  #define MOTOR1_IN_A -1 //DON'T TOUCH THIS! This is just a placeholder
  #define MOTOR1_IN_B -1 //DON'T TOUCH THIS! This is just a placeholder

  #define MOTOR2_PWM 5
  #define MOTOR2_IN_A -1 //DON'T TOUCH THIS! This is just a placeholder
  #define MOTOR2_IN_B -1 //DON'T TOUCH THIS! This is just a placeholder

  #define MOTOR3_PWM 22
  #define MOTOR3_IN_A -1 //DON'T TOUCH THIS! This is just a placeholder
  #define MOTOR3_IN_B -1 //DON'T TOUCH THIS! This is just a placeholder

  #define MOTOR4_PWM 4
  #define MOTOR4_IN_A -1 //DON'T TOUCH THIS! This is just a placeholder
  #define MOTOR4_IN_B -1 //DON'T TOUCH THIS! This is just a placeholder

  #define PWM_MAX 400
  #define PWM_MIN -PWM_MAX
#endif

// Wifi network settings
// Option 1: Enable WiFi by copying wifi_config.h.template in this directory
// to wifi_config.h and filling in your wifi credentials and IP addresses.
// wifi_config.h will be ignored by git, so your credentials will not be pushed to github,
// and will be private to you. This is the recommended option.
// Option 2: Enable WiFi below by filling in your wifi credentials and IP addresses.
// WARNING: if you push this file to git, your credentials will be public!

#if __has_include("wifi_config.h")
  #include "wifi_config.h"
#else
  // Enable WiFi with null terminated list of multiple APs SSID and password
  // #define WIFI_AP_LIST {{"WIFI_SSID", "WIFI_PASSWORD"}, {NULL}}
  #define AGENT_IP { 192, 168, 1, 100 }
  #define SYSLOG_SERVER { 192, 168, 1, 100 }
  #define LIDAR_SERVER { 192, 168, 1, 100 }
#endif

// Uncomment the line below to enable Arduino OTA updates.
// #define USE_ARDUINO_OTA
// Uncomment the line below to enable syslog for debugging over wifi.
// #define USE_SYSLOG

#define WIFI_MONITOR 2 // min. period to send wifi signal strength to syslog
#define AGENT_PORT 8888
#define SYSLOG_PORT 514
#define DEVICE_HOSTNAME "esp32"
#define APP_NAME "hardware"
// #define USE_LIDAR_UDP
//#define LIDAR_RXD 14
// #define LIDAR_PWM 15
//#define LIDAR_SERIAL 1 // uart number
//#define LIDAR_BAUDRATE 230400
//#define LIDAR_PORT 8889
#define BAUDRATE 921600
#define SDA_PIN 21 // specify I2C pins
#define SCL_PIN 22
#define NODE_NAME "esp32"
// #define TOPIC_PREFIX "esp32/"

// battery voltage ADC pin
//#define BATTERY_PIN 33
// 3.3V ref, 12 bits ADC, 33k + 10k voltage divider
// #define USE_ADC_LUT
#ifdef USE_ADC_LUT
const int16_t ADC_LUT[4096] = { /* insert adc_calibrate data here */ };
#define BATTERY_ADJUST(v) (ADC_LUT[v] * (3.3 / 4096 * (33 + 10) / 10 * 1.0))
#else
#define BATTERY_ADJUST(v) ((v) * (3.3 / 4096 * (33 + 10) / 10))
#endif
// #define USE_INA219
// #define TRIG_PIN 31 // ultrasonic sensor HC-SR04
// #define ECHO_PIN 32
//#define USE_SHORT_BRAKE // for shorter stopping distance
// #define WDT_TIMEOUT 60 // Sec
// BTS7960 ENABLE PINS
#define MOTOR1_REN 32
#define MOTOR1_LEN 25

#define MOTOR2_REN 13
#define MOTOR2_LEN 12

#define BOARD_INIT { \
    pinMode(MOTOR1_REN, OUTPUT); \
    pinMode(MOTOR1_LEN, OUTPUT); \
    pinMode(MOTOR2_REN, OUTPUT); \
    pinMode(MOTOR2_LEN, OUTPUT); \
    digitalWrite(MOTOR1_REN, HIGH); \
    digitalWrite(MOTOR1_LEN, HIGH); \
    digitalWrite(MOTOR2_REN, HIGH); \
    digitalWrite(MOTOR2_LEN, HIGH); \
    Wire.begin(SDA_PIN, SCL_PIN); \
    Wire.setClock(400000); \
}
// #define BOARD_INIT_LATE {}
// #define BOARD_LOOP {}

#ifdef USE_SYSLOG
#define RCCHECK(fn) { rcl_ret_t temp_rc = fn; if((temp_rc != RCL_RET_OK)){ \
    syslog(LOG_ERR, "%s RCCHECK failed %d", __FUNCTION__, temp_rc); \
    }}
#else
#define RCCHECK(fn) { rcl_ret_t temp_rc = fn; if((temp_rc != RCL_RET_OK)){ \
    flashLED(3); \
    }} // do not block
#endif

#endif
