DucMinhLe2005/Human-Aware---Social-Navigation/src_humanaware/src/linorobot2/linorobot2_bringup/config/box_laser_filter.yaml

scan_to_scan_filter_chain:
  ros__parameters:
  
    filter1:
      name: remove_left_bar
      type: laser_filters/LaserScanAngularBoundsFilterInPlace
      params:
        lower_angle: 1.4835
        upper_angle: 1.6581
        replace_with_nan: true

    filter2:
      name: remove_right_bar
      type: laser_filters/LaserScanAngularBoundsFilterInPlace
      params:
        lower_angle: -1.6581
        upper_angle: -1.4835
        replace_with_nan: true
