DucMinhLe2005/Human-Aware---Social-Navigation/(commit log)

2026-08-17 Initial commit - Human-Aware Social Navigation
    [2wd.urdf.xacro, 2wd_properties.urdf.xacro, 4wd.urdf.xacro, 4wd_properties.urdf.xacro, base.urdf.xacro, caster_wheel.urdf.xacro, depth_sensor.urdf.xacro, diff_drive.urdf.xacro]
2026-09-22 Add real robot and CAD images to README
2026-09-22 Fix CAD image asset
2026-09-22 Expand project README and fix CAD image
2026-09-22 Show CAD image beside real robot in README
2026-09-22 Fix CAD image rendering in README
2026-09-22 Add clean CAD SVG preview
2026-09-23 Add correct CAD image
2026-10-05 Configure Git LFS for CAD archive and models
2026-10-07 Add the human-aware simulation workspace and its results
    Add src_humanaware/: the social_nav packages (perception, tracking,
    costmap layer, controller, safety, Gazebo tools), the simulation
    configuration and the 100-run evaluation. Build, install, log and
    results directories are left out. Update the top-level README to point
    to the new workspace and summarise the simulation results.
    Claude-Session: https://claude.ai/code/session_01SUYxb1HAagLMB2MZPxVRWs
    [2wd.urdf.xacro, 2wd_properties.urdf.xacro, 4wd.urdf.xacro, 4wd_properties.urdf.xacro, Nurse.obj, Nurse_Col.obj, base.urdf.xacro, base_link.STL]
2026-10-10 Add Nav2 + DWB baseline config generator and install switch
    make_dwb_yaml.py derives the baseline from the PS-VSP navigation.yaml:
    DWB with Nav2 default critics and the same speed/acceleration limits,
    social layer removed from both costmaps; nothing else may differ.
    use_config.sh swaps the installed navigation.yaml and restores it.
    src_humanaware is not modified.
    Claude-Session: https://claude.ai/code/session_01MyjBvDNvy2LMTiSQXfYQoS
2026-10-10 Baseline switch: add dwb_social (DWB on the social costmap) ablation
    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
2026-10-11 Baseline switch: PS-VSP without social layer ablation; DWB debug mode
    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
2026-10-11 run_phase_batch.sh: resume an interrupted batch with START_SLOT
    Continues the same schedule in the same directory; refuses if the schedule
    or the installed navigation.yaml differs from the original batch; records
    the resume in resume.txt.
    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
2026-10-13 Baseline switch: Nav2 MPPI (mppi, mppi_social)
    MPPI with the parameters of nav2_bringup/params/nav2_params.yaml (jazzy),
    except the PS-VSP velocity/acceleration limits and visualize=false.
    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
